electrocifiligrama/CONTROL_TP1/Informe/Informe_TP1.pdf

Instituto Tecnológico de Buenos Aires

22.85 Sistemas de Control

Trabajo Práctico de Laboratorio No 1

# PLL

Grupo 5:

Matías Larroque
Leg. 56597

Lucero Guadalupe Fernandez Leg. 57485

Manuel Mollón
Leg. 58023

Ezequiel Vijande
Leg. 58057

Tomás Agustín González Orlando
Leg. 57090

Robin Bertrand
Leg. 61739

Profesor:

Victor Gustavo Nasini
Cristian Alejo Zujew

Entregado: 27 de Septiembre de 2019

## Índice

1. Introducción | 2
2. Resumen y Objetivos | 2
3. Cálculo teórico | 2
4. Resultados | 5
5. Conclusiones | 8

## 1. Introducción

En el siguiente informe se presenta el análisis y los resultados obtenidos de utilizar un PLL (Phase Locked Loop) como demodulador de una señal modulada en FM. Un PLL es un sistema retroalimentado que puede ser modelado por el siguiente diagrama en bloques:

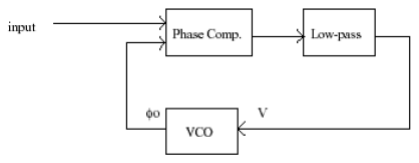
[picture p1: figure]

Figura 1: Diagrama en bloques genérico de un PLL

En términos generales un PLL se utiliza para detectar cambios de fase en la señal de entrada y otorgar una salida proporcional a los mismos. El primer bloque del diagrama es el comparador de fase cuya salida luego se filtra y se usa como entrada de un VCO(Voltage Controlled Oscillator) que proporciona una señal con frecuencia proporcional a la diferencia de fase detectada. La realimentación del sistema permite que la fase de la señal a la salida del VCO se “enganche” a la fase de la señal de entrada.

## 2. Resumen y Objetivos

## 3. Cálculo teórico

El circuito a analizar se puede modelar como el siguiente diagrama en bloques:

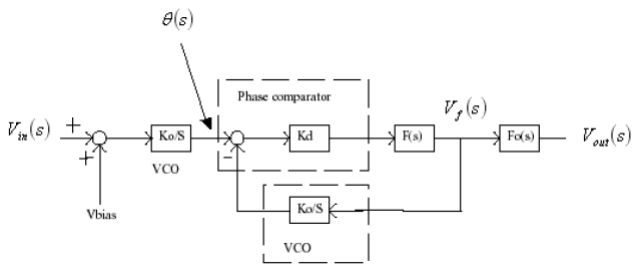
[picture p2: figure]

Figura 2: Diagrama en bloques del cicruito

Analizando el diagrama en bloques por partes se pueden sacar distintas ganancias dentro del esquema. De la figura (2) se tiene que la ganancia del modulador FM es:

θ(S)
Vin(S)

=

K0
S

(1)

Tomando:

α = KdF(S) y β =

K0
S

Para el PLL en cuestión se tiene que la ganancia es:

Vf (S)
θ(S) =

1
β

αβ
1+αβ =

α
1+αβ =

KdF (S)

1+ KdK0F (s)
S

Vf (S)
θ(S)

=

KdF(S)S
S + KdK0F(S)

(2)

La transferencia F(S) corresponde al filtro pasabajos utilizado. Analizando el caso de filtros pasabajos pasivos, utilizando resistencias y capacitores, se analizan las siguientes dos configuraciones:

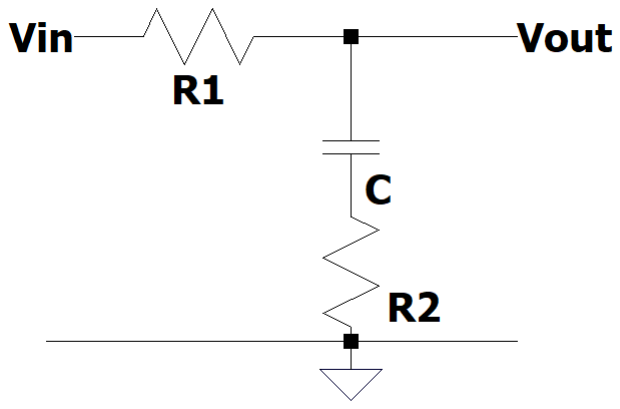
[picture p3: figure]
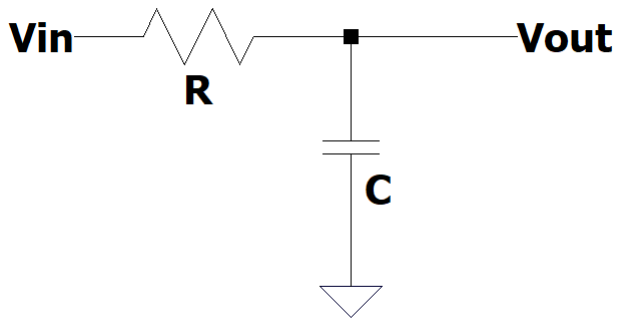
[picture p4: figure]

(a) F1(s) | (b) F2(S)

Figura 3: Configuraciones analizadas para F(S)

Para ambos filtros, la transferencia se obtiene haciendo simplemente un divisor de impedancias. Para la primera configuración se tiene:

Vout
Vin

=

1
SC
R+ 1
SC

=

1
SRC+1

F1(S) = 1

S
ω0

+ 1

; ω0 =

1
RC | (3)

Para la segunda configuración, se despeja a su vez:

Vout
Vin

=

1
SC +R2
R1+R2+ 1
SC

=

S·C·R2+1
S·(R1+R2)·C+1
F2(S) = | S · τ2 + 1
S(τ1 + τ2) + 1; τ1 = C.R1, τ2 = C.R2 | (4)

Se procede a calcular la ganancia Vf (S)
θ(S)

para las distintas configuraciones posibles de F(s):

Con F(s) = F1(s):

V (s)
θ(S) =

Kd·s
s
ω0

+1 ·

1
s+

Kd·K0
s
w0

+1

=

Kd·s
s
ω0

+1 ·

s
ω0

+1

s2
ω0

+s+Kd·K0

V (s)
θ(S)

=

Kd · s

s

2
ω0

+ s + Kd · K0

(5)

Reescribiendo la expresión (5) se puede obtener cuál es el factor de amortiguamiento del sistema:

k. s
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
= ✟K✟d
✟K✟dK0

s
( √ s
ω0KdK0

)

2+ 1 KdK0
s+1

De la expresión anterior se tiene que:

k =

1
K0

ωc =

√
ω0KdK0

2ξ
ωc

=

1
KdK0 → ξ =

ωc
2KdK0

ξ =

1
2

r ω0
KdK0

(6)

Con F(s) = F2(s):

V (s)
θ(S) = Kd · s ·

s·τ2+1
s(τ1+τ2)+1 ·

1
s+

Kd·K0·(s·τ2+1)
s·(τ1+τ2)+1

=

Kd·s·(s·τ2+1)
s

2·(τ1+τ2)+s+s·τ2·Kd·K0+Kd·K0

V (s)
θ(S)

=

Kd · s

2
- τ2 + Kd · s
s

2 · (τ1 + τ2) + s · (1 + Kd · K0τ2) + Kd · K0

(7)

Al igual que para el caso anterior reescribimos la expresión para hallar el factor de amortiguamiento del sistema:
k. s

2
τ2+s
(

s
ωc

)

2+

2ξ
ωc

s+1 = ✚K✚d
✚K✚dK0

s

2
τ2+s
q s
KdK0
τ1+τ2

2

+

1+KdK0

τ2
KdK0

s+1

De la ecuación anterior se obtiene que los parámetros son:

k =

1
K0

ωc =

qKdK0
τ1+τ2

2ξ
ωc

=

1+KdK0τ2
KdK0 → ξ =

ωc
2

1+KdK0τ2
KdK0

ξ =

1 + KdK0τ2
2

p
KdK0(τ1 + τ2)

(8)

Para el filtro pasabajos a la salida del circuito se utilizó un filtro pasivo RC como el de la primera configuración por lo que:

F0(s) = 1

s
ωp
| + 1

(9)

Entonces la transferencia completa del circuito para el caso F(s) = F1(s):

Vout(s)
Vin(s) =

K0
s

Vf (s)
θ(s)

.F0(s) = KdK0
s2
ω0
| +s+KdK0
s
ωp

+1 =

KdK0
s3
ω0ωp

+s

2(
ω0

ωp

)+s(1+ KdK0
ωp

)+KdK0

Vout(s)
Vin(s)

=

KdK0

s

3
ω0ωp

+ s

2 ωp+ω0
ω0ωp

+ s

ωp+KdK0
ωp

+ KdK0

(10)

y para el caso F(s) = F2(s):

Vout(s)
Vin(s) =

K0
s

Vf (s)
θ(s)
.F0(s) = | Kd·K0.s·τ2+Kd·K0
s
| 2·(τ1+τ2)+s·(1+Kd·K0τ2)+Kd·K0

1
s
ωp

+1 =

Kd·K0.s·τ2+Kd·K0
s

3

(τ1+τ2)
ωp

+s

2(

1+KdK0τ2 ωp | +τ1+τ2)+s( KdK0 ωp +1+KdK0τ2)+KdK0

Vout(s)
Vin(s)

=

KdK0τ2s + KdK0

s

3 τ1+τ2
ωp

+ s

2

1+KdK0τ2+ωp(τ1+τ2)
ωp

+ s

KdK0+ωp(1+KdK0τ2)
ωp

+ KdK0

(11)

## 4. Resultados

Se calculó numéricamente la función transferencia, obteniéndose para el caso F1(s):

H1(s) = | 2, 9,10⁶
5, 6,10⁻¹²s
| 3 + 1, 1,10⁻⁵s 2 + 2,6s + 2, 9,10⁶

A partir de las mediciones se midió la constante K0, ver figura 4. El valor obtenido fue de K0 = 921352 rad/s/V . También se calculó el coeficiente de amortiguamiento ξ = 0,092 y la frecuencia natural de los polos conjugados wo = 0, 54,10⁶
rad/s.
Lo mismo se repitió para el caso del filtro con transferencia F2(s), resultando en un amortiguamiento de ξ = 0,537 y una frecuencia natural de wo = 0, 498,10⁶
rad/s.
La transferencia total en este caso resultó en:
H2(s) = | 5, 28s + 2, 9,10⁶
6,6,10⁻¹²s
| 3 + 1, 5,10⁻⁵s 2 + 7, 9s + 2, 9,10⁶

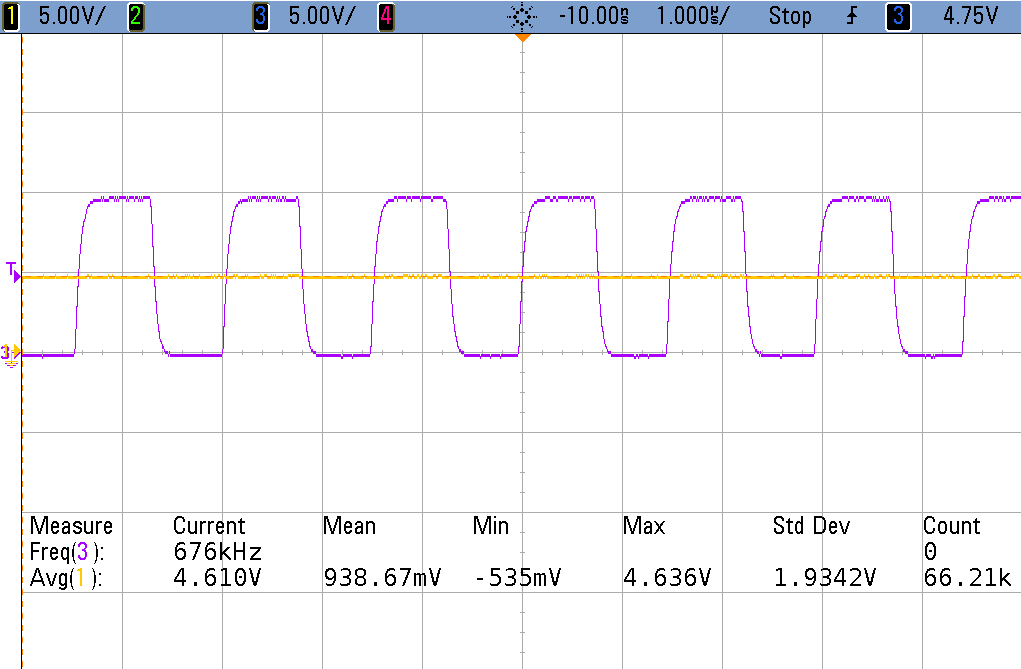
[picture p5: figure]

Figura 4: Medición del K0.

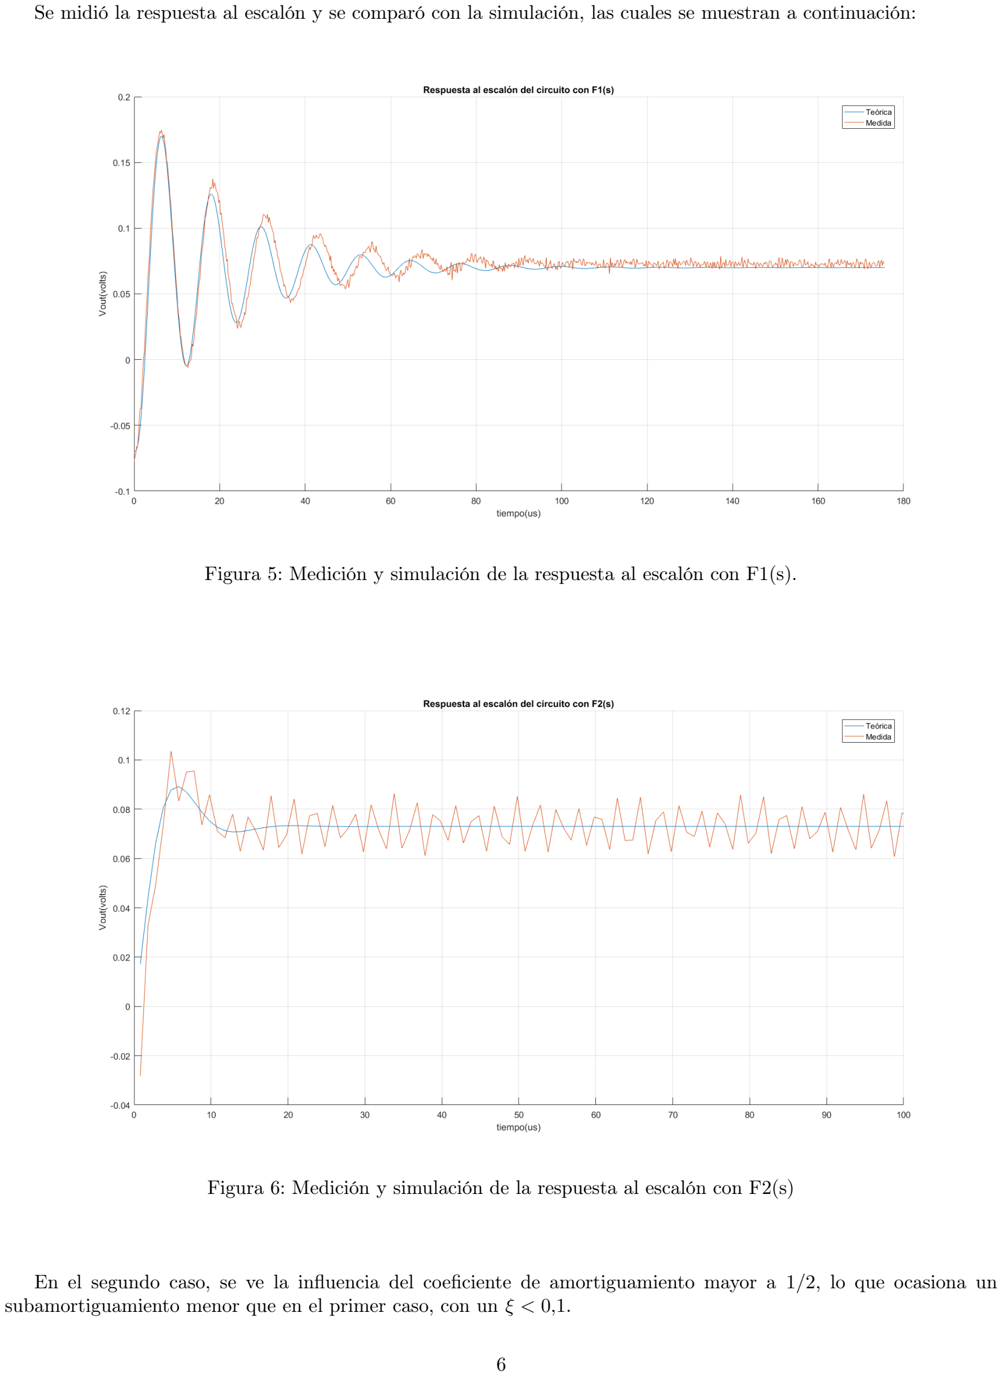
[picture p6: page 7]

Se midió la respuesta al escalón y se comparó con la simulación, las cuales se muestran a continuación:

Figura 5: Medición y simulación de la respuesta al escalón con F1(s).

Figura 6: Medición y simulación de la respuesta al escalón con F2(s)

En el segundo caso, se ve la influencia del coeficiente de amortiguamiento mayor a 1/2, lo que ocasiona un subamortiguamiento menor que en el primer caso, con un ξ < 0,1.

Si se desea un amortiguamiento de ξ = 0,5, el valor de la resistencia en serie con el capacitor debe ser de 1,65kΩ. A continuación se muestra la influencia de dicha resistencia sobre el amortiguamiento del sistema.

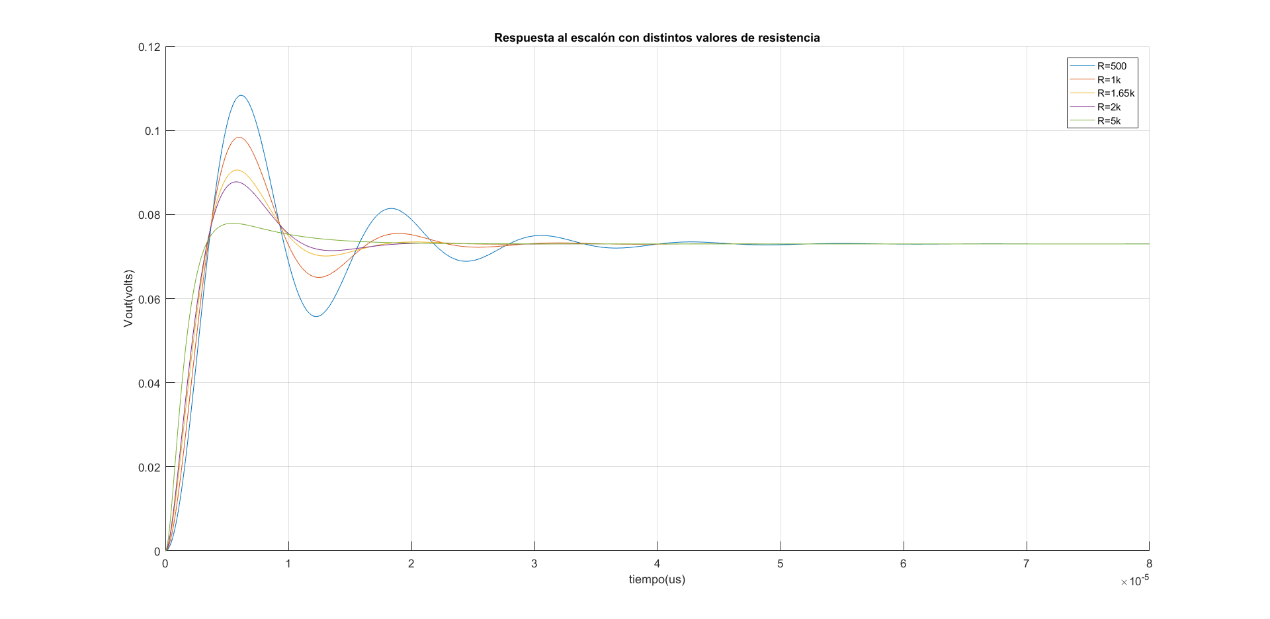
[picture p7: figure]

Figura 7: Simulación de la respuesta al escalón para distintos valores de resistencias.

Esto se verificó además experimentalmente, con un jumper cortocircuitando la resistencia mencionada.

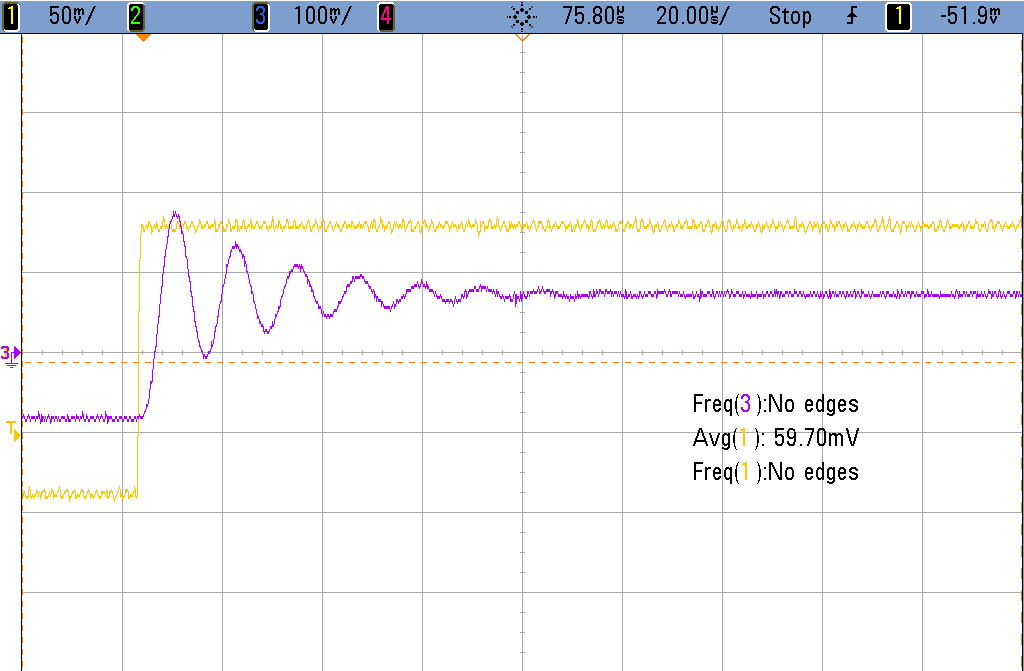
[picture p8: figure]

Figura 8: Con resistencia de 1,65kΩ en serie.

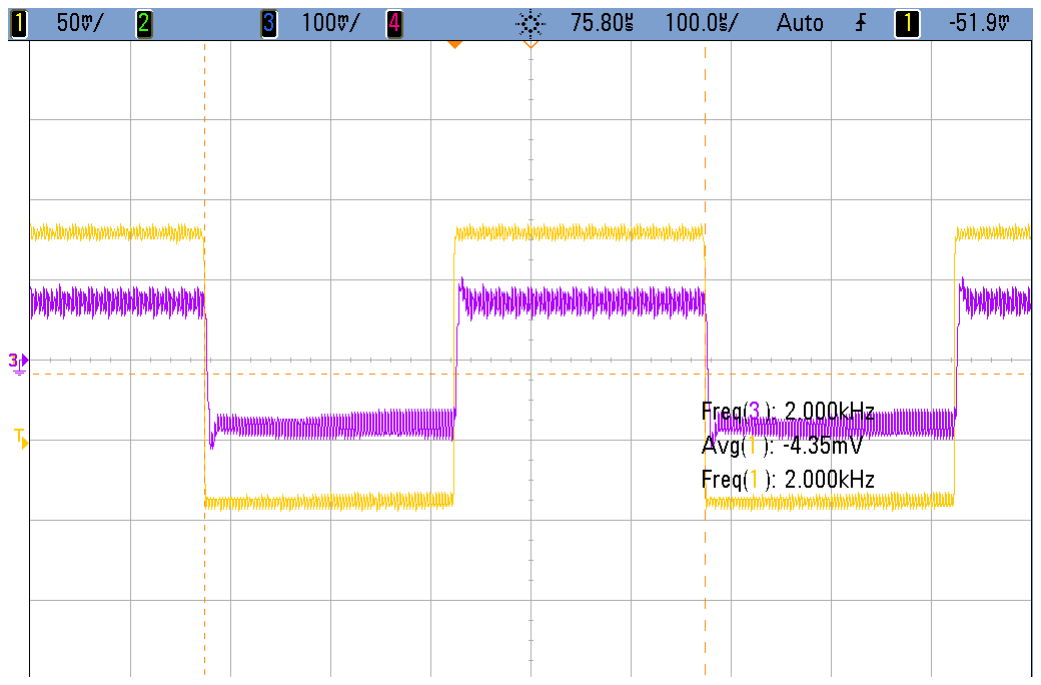
[picture p9: figure]

Figura 9: Sin resistencia en serie.

## 5. Conclusiones

Se consiguió satisfactoriamente obtener los parámetros del PLL, condiciéndose los cálculos teóricos con los calcu-lados numéricamente y simulados mediante MATLAB, como así también, se verificó experimentalmente la función de la resistencia en serie al capacitor, que modifica el coeficiente de amortiguamiento del circuito. Además, se deduce que el filtro a la salida se utiliza para filtrar la señal de la portadora cuando se utiliza al PLL para demodular FM.
