electrocifiligrama/CONTROL_TP1/Informe/Imagenes/CircuitoTotalDiagramaEnBloques.PNG

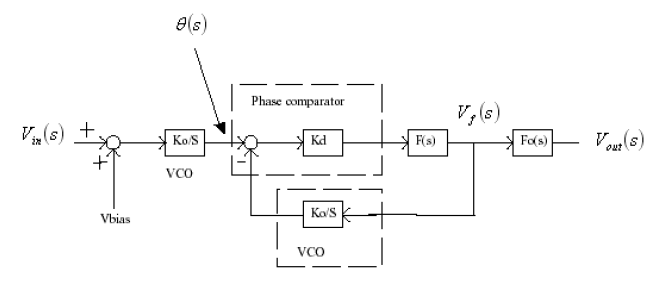
Informe/Imagenes/CircuitoTotalDiagramaEnBloques.PNG
