electrocifiligrama/CONTROL_TP1/Informe/Imagenes/F1.PNG

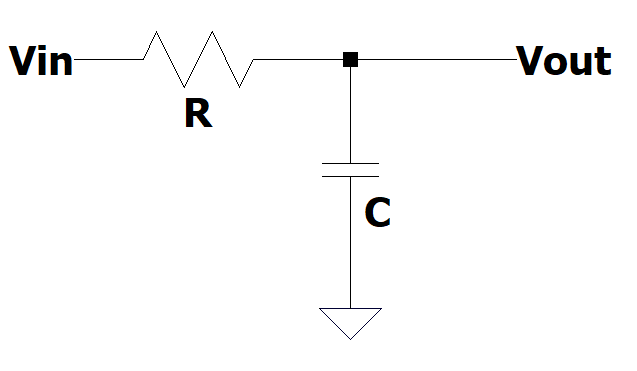
Informe/Imagenes/F1.PNG
