electrocifiligrama/CONTROL_TP1/Informe/Imagenes/F2.PNG

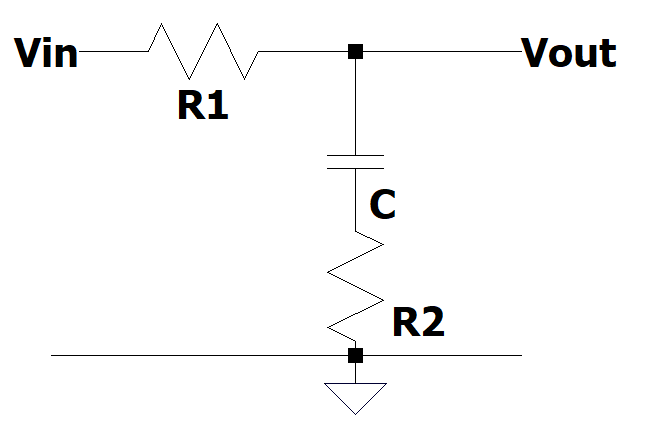
Informe/Imagenes/F2.PNG
