electrocifiligrama/CONTROL_TP1/Informe/Imagenes/MedicionConF1.png

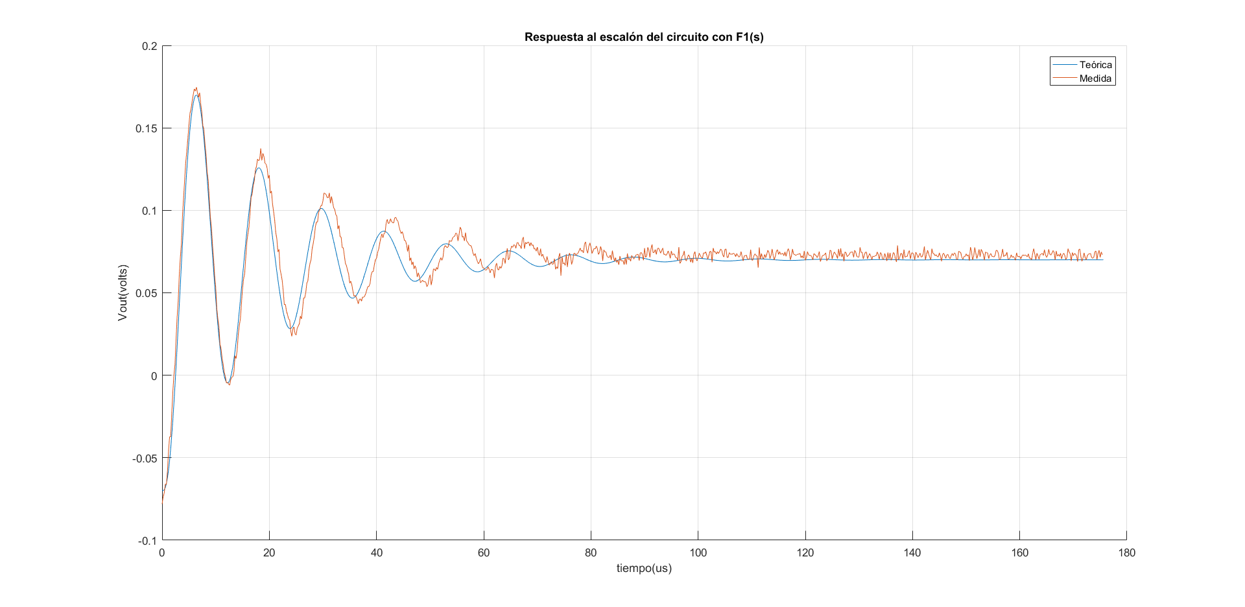
Informe/Imagenes/MedicionConF1.png
