electrocifiligrama/CONTROL_TP1/Informe/Imagenes/MedicionConF2.png

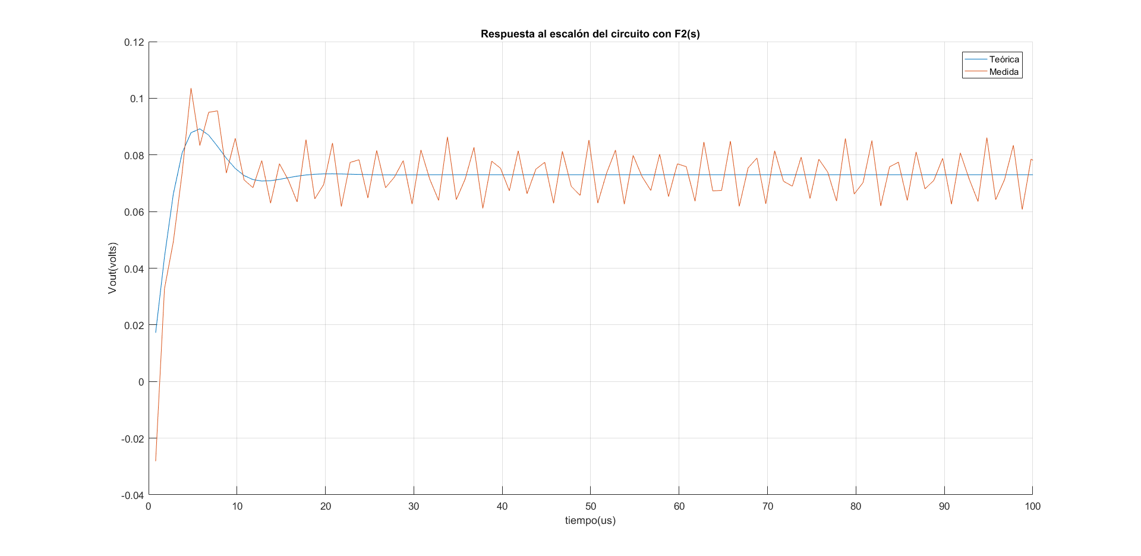
Informe/Imagenes/MedicionConF2.png
