electrocifiligrama/CONTROL_TP1/Informe/Imagenes/PLL_diagrama_en_bloques.PNG

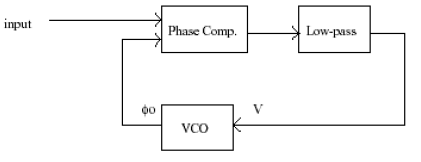
Informe/Imagenes/PLL_diagrama_en_bloques.PNG
