electrocifiligrama/CONTROL_TP1/Informe/Imagenes/rtaEscalonconJumper.png

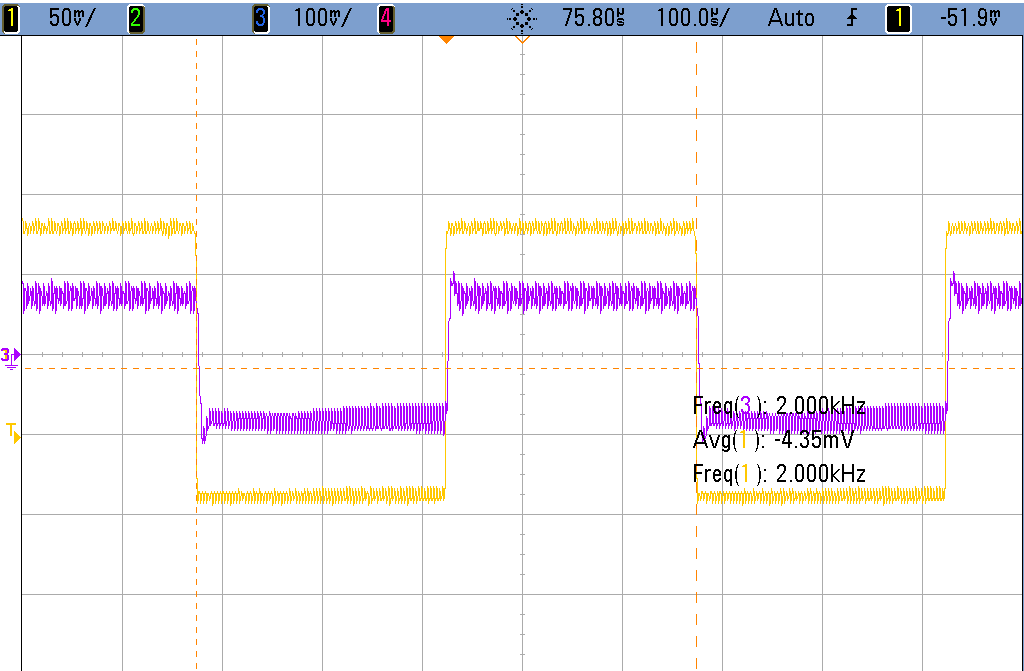
Informe/Imagenes/rtaEscalonconJumper.png
