electrocifiligrama/CONTROL_TP1/medicionesControlTP1/med1Ko.png

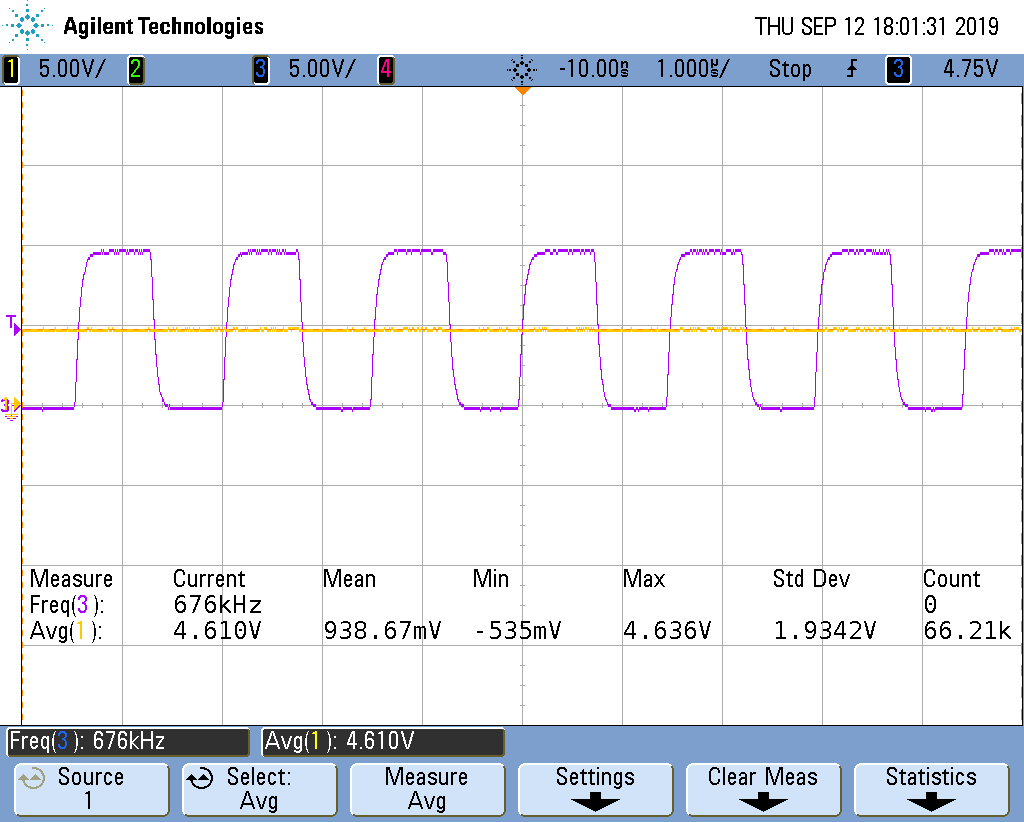
medicionesControlTP1/med1Ko.png
