electrocifiligrama/CONTROL_TP1/medicionesControlTP1/med2Ko.png

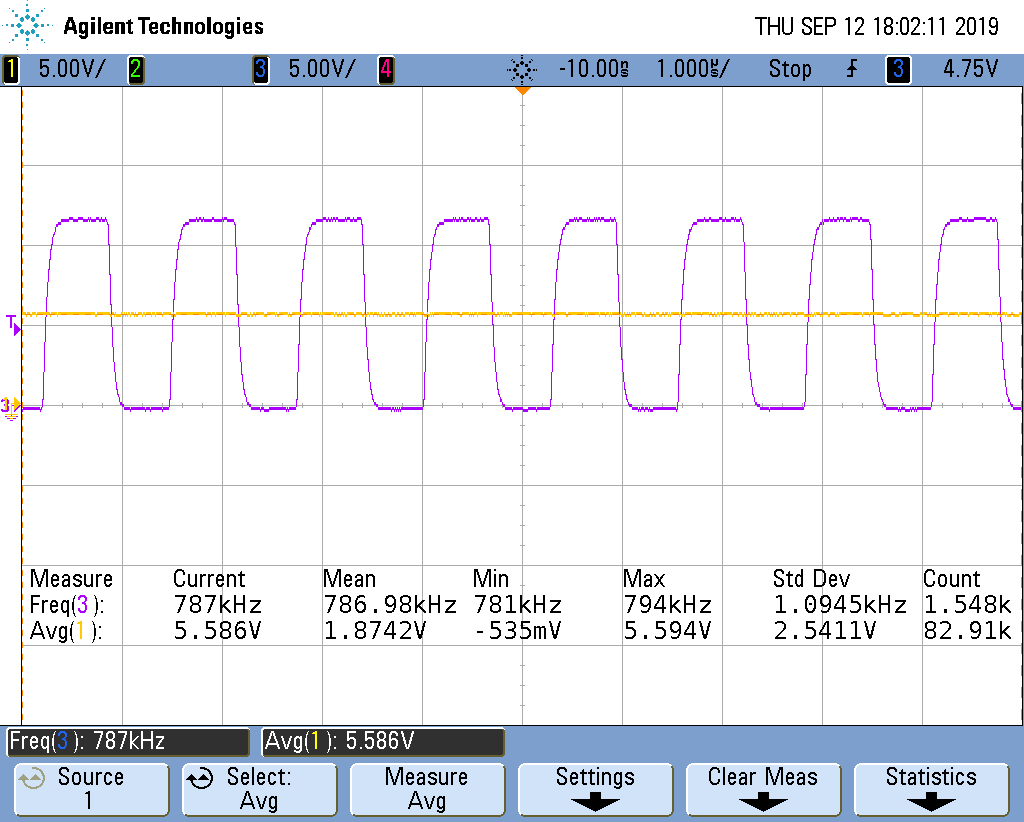
medicionesControlTP1/med2Ko.png
