electrocifiligrama/CONTROL_TP1/medicionesControlTP1/med3Ko.png

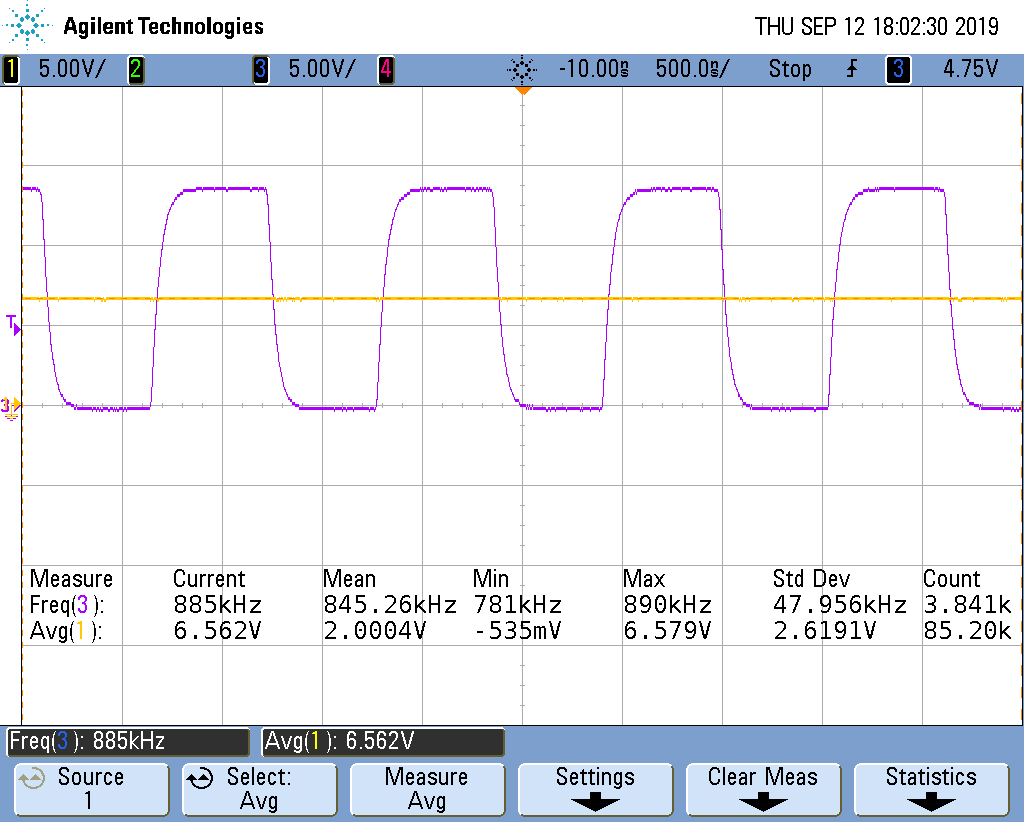
medicionesControlTP1/med3Ko.png
