electrocifiligrama/CONTROL_TP1/medicionesControlTP1/muestraDeModulacion.png

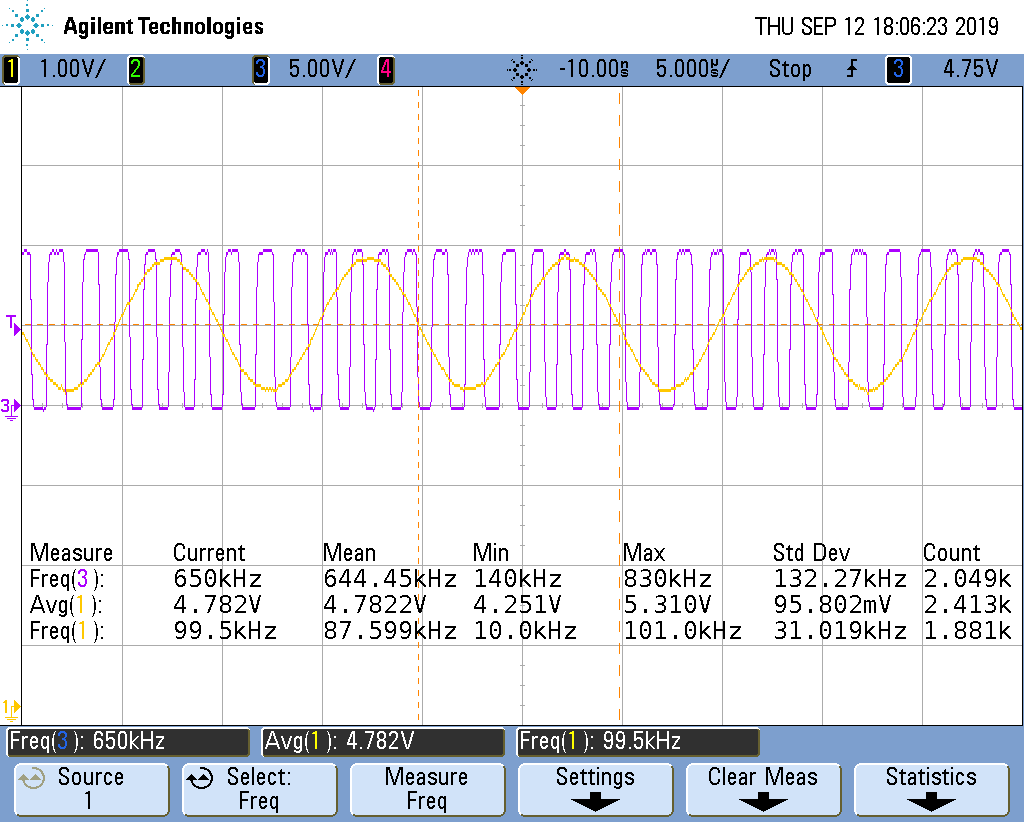
medicionesControlTP1/muestraDeModulacion.png
