electrocifiligrama/CONTROL_TP1/medicionesControlTP1/rtaEscalonconJumper.png

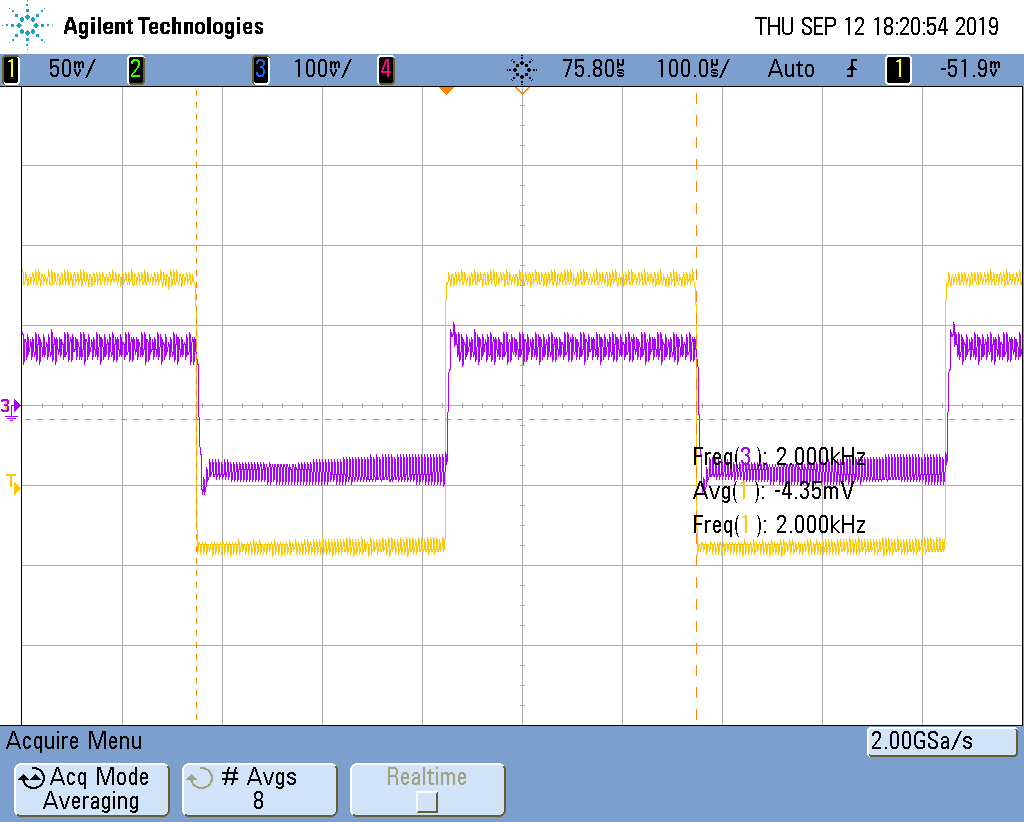
medicionesControlTP1/rtaEscalonconJumper.png
