electrocifiligrama/CONTROL_TP1/medicionesControlTP1/rtaEscalonsinJumper.png

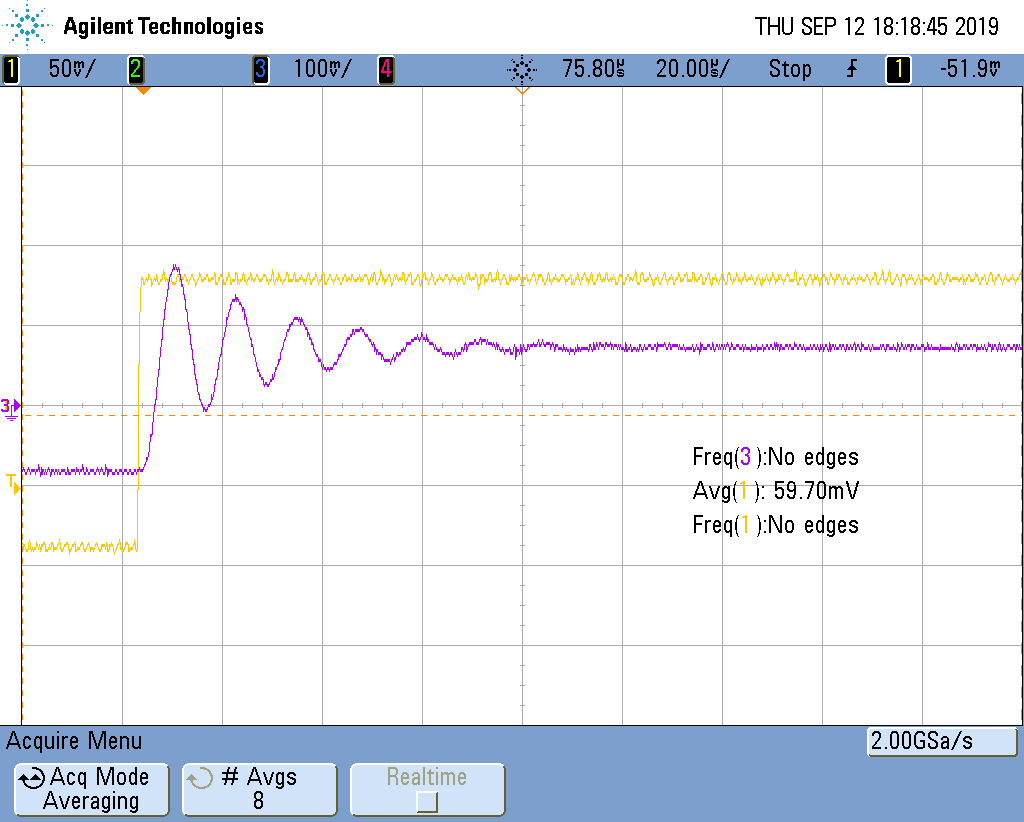
medicionesControlTP1/rtaEscalonsinJumper.png
