electrocifiligrama/CONTROL_TP1/PCB/Bill_of_materials.png

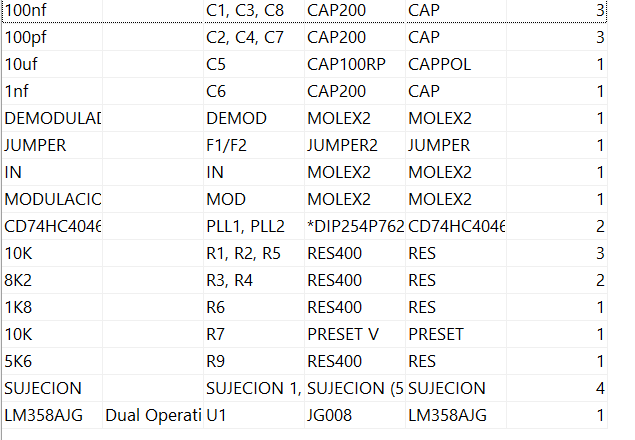
PCB/Bill_of_materials.png
