electrocifiligrama/CONTROL_TP1/(list of files, drawings)

Other design files:
PCB/PCB_Project/PCB_Project.PrjPcb
PCB/PCB_Project/TP1.PcbDoc
PCB/PCB_Project/TP1.SchDoc
