electrocifiligrama/CONTROL_TP1/(commit log)

2019-09-04 Toque un poco el PCB
    [PCB_Project.PrjPcb, TP1.PcbDoc]
2019-09-08 Empece el informe
2019-09-11 Falta un poco de las cuentas, las mediciones y simulaciones
2019-09-20 Empece la simulacion en control
2019-09-21 Falta la grafica para F2
2019-09-25 faltan conclusiones tp1 (qué funcion cumple el filtro a la salida)
